frazentropy/Alarm/Alarm.sch

## EAGLE design Alarm.sch (2018-01-12)

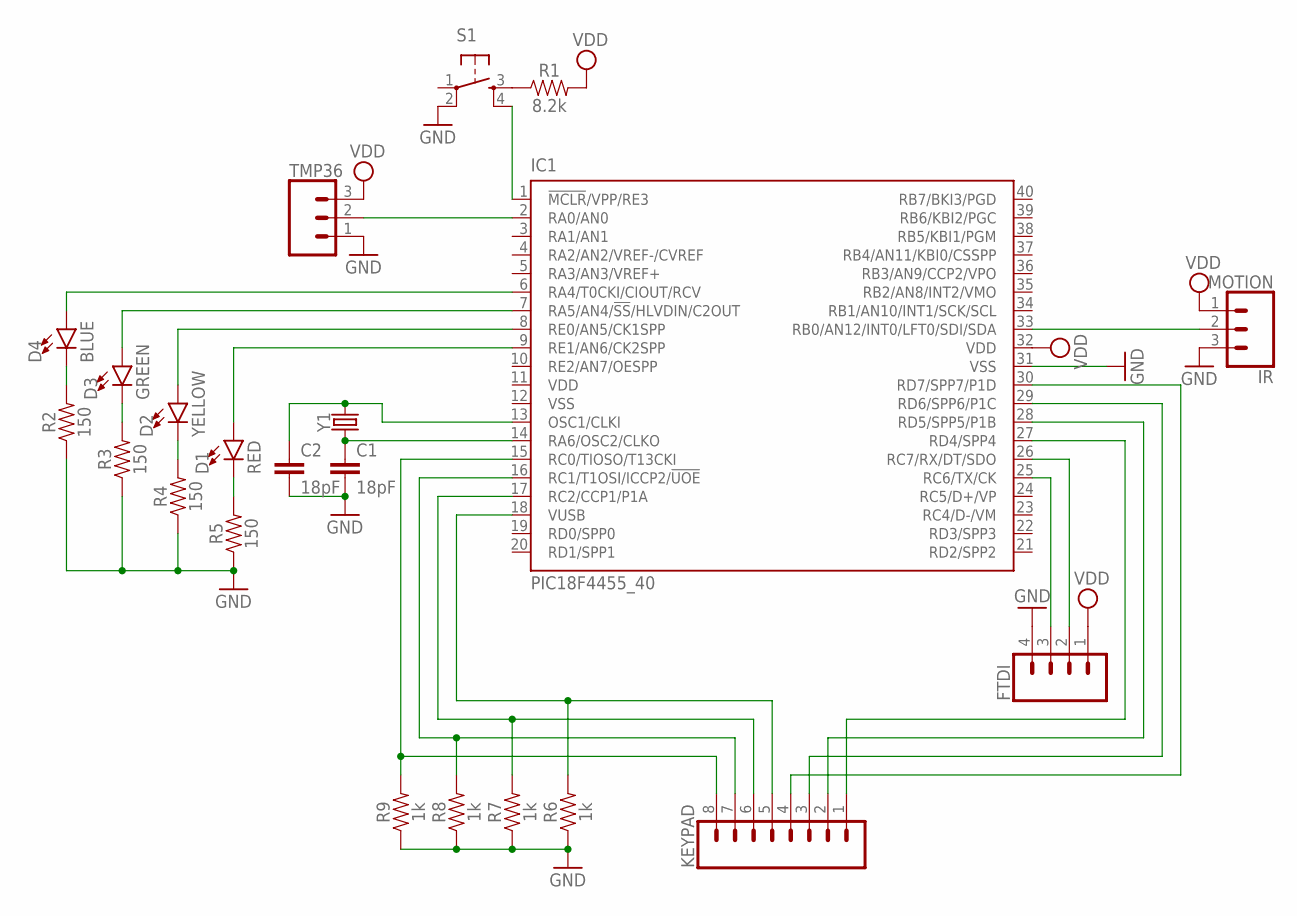
[picture p3: schematic Alarm.sch]

Parts:
C1, C2: 18pF; 0402
D1: RED; LED-0603
D2: YELLOW; LED-0603
D3: GREEN; LED-0603
D4: BLUE; LED-0603
FTDI: CONN_04; 1X04
IC1: PIC18F4455_40; DIL40
IR: MOTION; 1X03
KEYPAD: CONN_08"; 1X08
R1: 8.2k; 1210
R2, R3, R4, R5: 150; 1210
R6, R7, R8, R9: 1k; 1210
S1: TAC_SWITCHPTH; TACTILE-PTH
TMP36: CONN_03; 1X03
Y1: CRYSTALPTH-HC49US; HC49US

Connections:
GND: C1.2, C2.2, FTDI.4, IC1.31 (VSS), IR.3, R2.1, R3.1, R4.1, R5.1, R6.1, R7.1, R8.1, R9.1, S1.2, TMP36.1
unnamed: C1.1, IC1.14 (RA6/OSC2/CLKO), Y1.1
unnamed: C2.1, IC1.13 (OSC1/CLKI), Y1.2
unnamed: IC1.33 (RB0/AN12/INT0/LFT0/SDI/SDA), IR.2
unnamed: FTDI.2, IC1.26 (RC7/RX/DT/SDO)
unnamed: FTDI.3, IC1.25 (RC6/TX/CK)
unnamed: IC1.2 (RA0/AN0), TMP36.2
unnamed: IC1.1 (!MCLR!/VPP/RE3), S1.4
unnamed: R1.1, S1.3
unnamed: D4.A, IC1.6 (RA4/T0CKI/CIOUT/RCV)
unnamed: D3.A, IC1.7 (RA5/AN4/!SS!/HLVDIN/C2OUT)
unnamed: D2.A, IC1.8 (RE0/AN5/CK1SPP)
unnamed: D1.A, IC1.9 (RE1/AN6/CK2SPP)
unnamed: D4.C, R2.2
unnamed: D3.C, R3.2
unnamed: D2.C, R4.2
unnamed: D1.C, R5.2
unnamed: IC1.27 (RD4/SPP4), KEYPAD.1
unnamed: IC1.28 (RD5/SPP5/P1B), KEYPAD.2
unnamed: IC1.29 (RD6/SPP6/P1C), KEYPAD.3
unnamed: IC1.30 (RD7/SPP7/P1D), KEYPAD.4
unnamed: IC1.15 (RC0/TIOSO/T13CKI), KEYPAD.8, R9.2
unnamed: IC1.17 (RC2/CCP1/P1A), KEYPAD.6, R7.2
unnamed: IC1.16 (RC1/T1OSI/ICCP2/!UOE), KEYPAD.7, R8.2
unnamed: IC1.18 (VUSB), KEYPAD.5, R6.2
VDD: FTDI.1, IC1.32 (VDD), IR.1, R1.2, TMP36.3
